CJT-Robotics/hardware-docs/README.md

# hardware-docs
Short and consise wiki for our hardware

>[!TIP]
>Click on the **Wiki** tab shown here, to access the hardware documentation wiki.
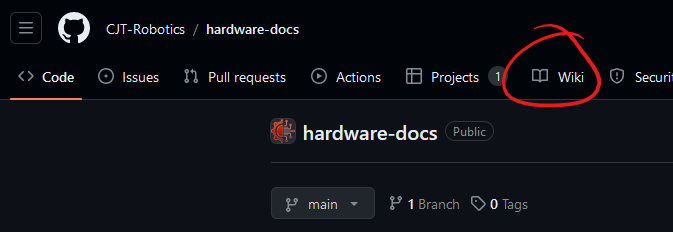
[picture p1: assets/images/klick-here.png]
instruction (https://github.com/CJT-Robotics/hardware-docs/wiki)
>
>
>Or click [HERE](https://github.com/CJT-Robotics/hardware-docs/wiki) to access the Wiki.
