CJT-Robotics/hardware-docs/assets/images/XT90-to-XT60-PCB/XT90-to-XT60-PCB-(3).png

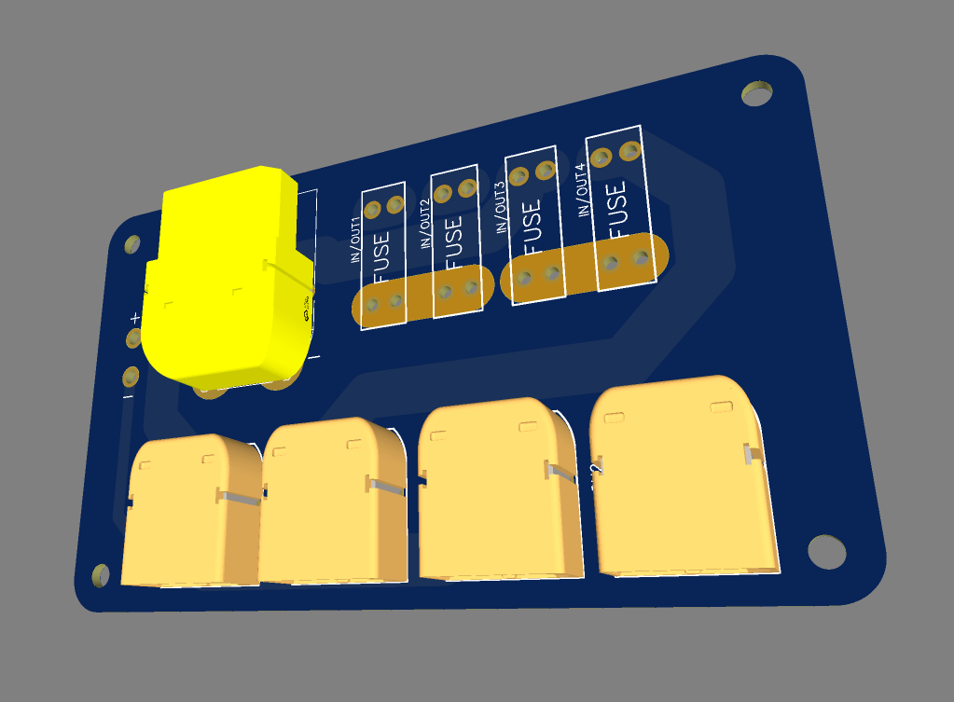
assets/images/XT90-to-XT60-PCB/XT90-to-XT60-PCB-(3).png
