CJT-Robotics/hardware-docs/assets/gerber/PCB_xt90 to xt60_2024-04-02.dxf

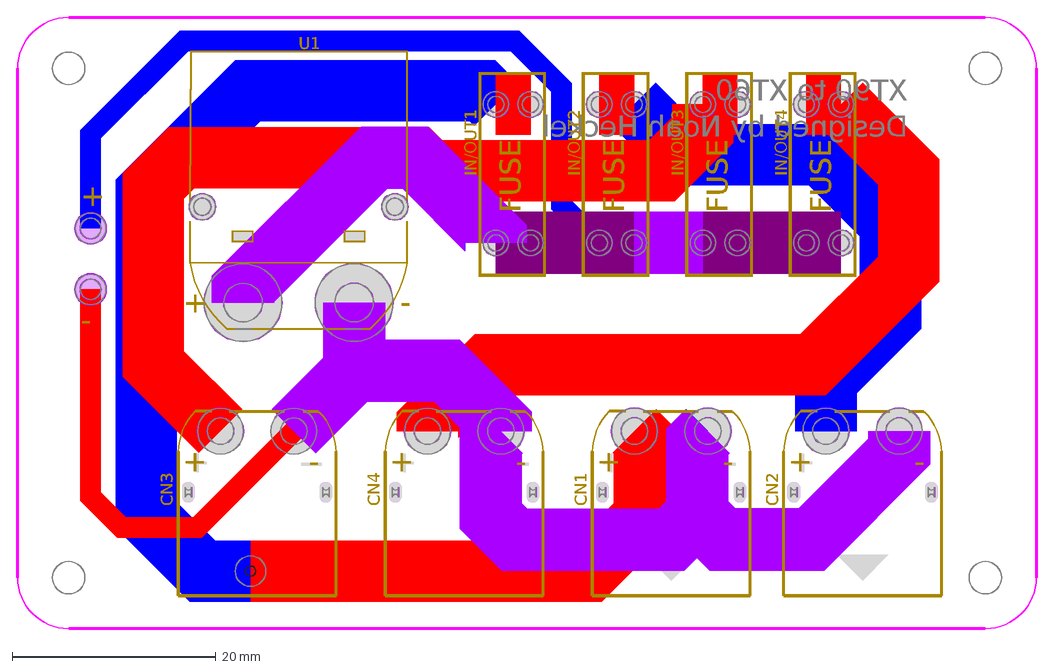
[picture p10: CAD file, 2024-04-02]
assets/gerber/PCB_xt90 to xt60_2024-04-02.dxf
+
-
XT90 to XT60
Designed by Noah Heckel
IN/OUT1
FUSE
IN/OUT2
IN/OUT3
IN/OUT4
CN1
CN2
CN3
CN4
U1
