CJT-Robotics/hardware-docs/assets/PDFs/Weel-Hub-drawings-v10-(FINAL).pdf

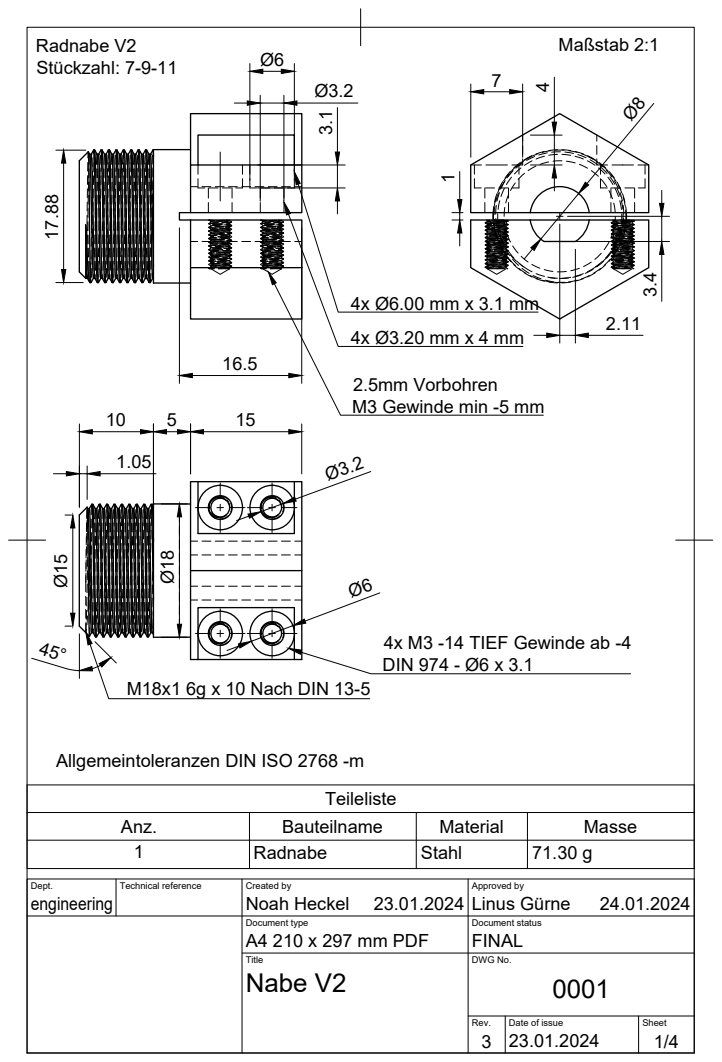
[picture p11: page 1]
DIN 974 - Ø6 x 3.1 3.1; M18x1 6g x 10 Nach DIN 13-5; Radnabe V2; Maßstab 2:1; Stückzahl: 7-9-11 17.88

2.5mm Vorbohren
M3 Gewinde min -5 mm

4x M3 -14 TIEF Gewinde ab -4

Allgemeintoleranzen DIN ISO 2768 -m

Anz. | Bauteilname | Material | Masse
1 | Radnabe | Stahl | 71.30 g

Dept. engineering | Technical reference | Created by Noah Heckel 23.01.2024 | Approved by Linus Gürne 24.01.2024

Document type A4 210 x 297 mm PDF | Document status FINAL

Title Nabe V2 | DWG No. 0001

Rev. 3 | Date of issue 23.01.2024 | Sheet

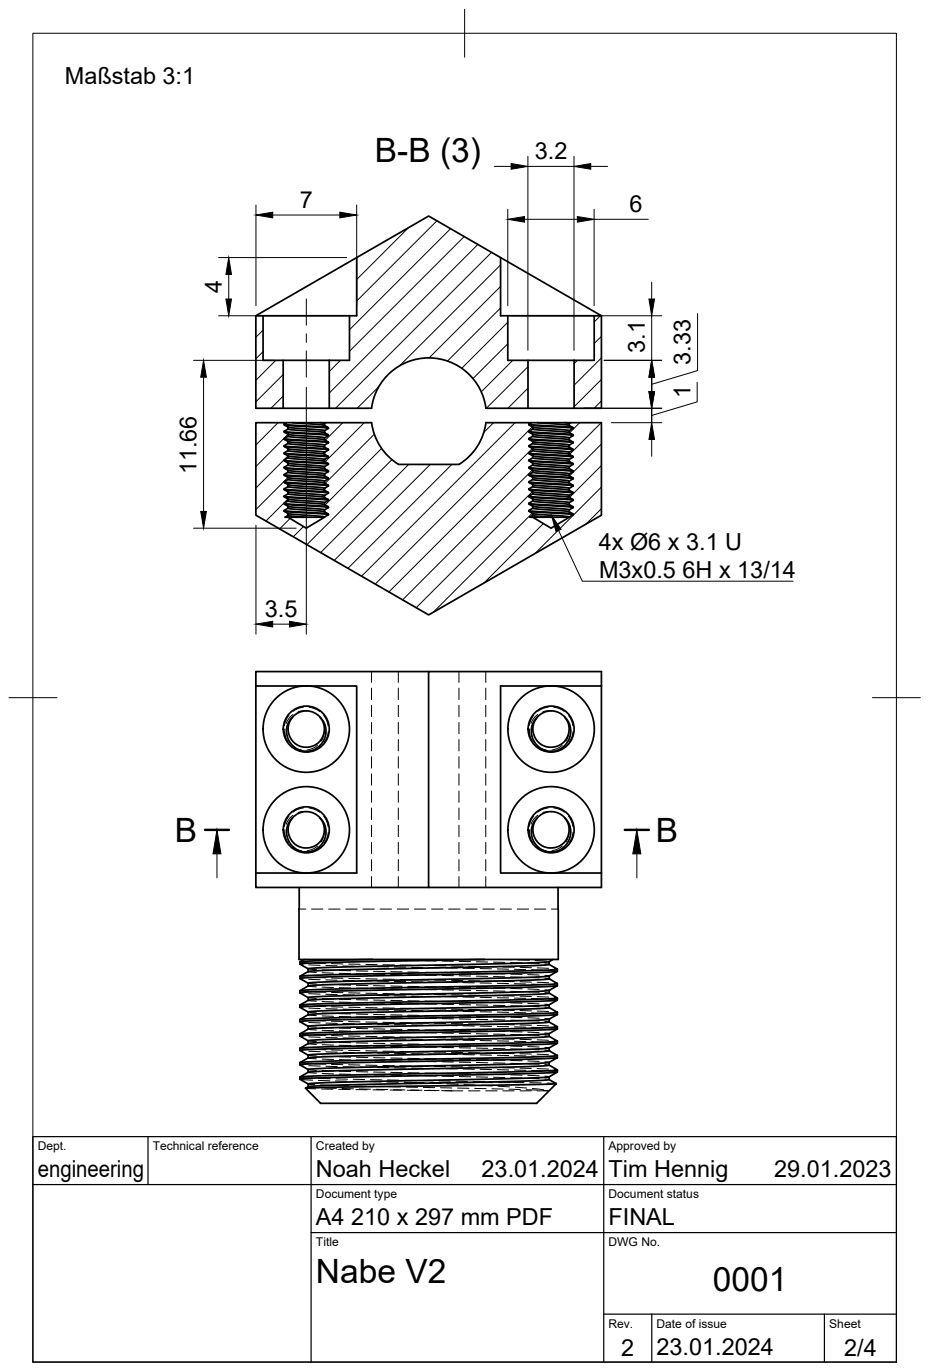
[picture p12: page 2]
Maßstab 3:1

Dept. engineering | Technical reference | Created by Noah Heckel 23.01.2024 | Approved by Tim Hennig 29.01.2023

Document type A4 210 x 297 mm PDF | Document status FINAL

Title Nabe V2 | DWG No. 0001

Dept. engineering | Technical reference | Created by Noah Heckel 23.01.2024 | Approved by Tim Hennig 29.01.2023
| | Document type A4 210 x 297 mm PDF | Document status FINAL
| | Title Nabe V2 | DWG No. 0001
Rev. | Date of issue | Sheet

Rohling

Material | Typ | Länge | Toleranz
11SMn30/37+C | Sechskant SW 24 | 27mm | h11 oder besser

Toleranzen nach DIN ISO 2768

| 0,5-3 | 3-6 | 6-30 | 30-120 | 120-400 | 400-1000 | 1000-200 0 | 2000-400 0
fein (f) | ±0,05 ±0,10 | ±0,05 ±0,10 | ±0,20 ±0,1 | ±0,15 ±0,30 | ±0,5 ±0,2 | ±0,3 ±0,8 | ±0,5 ±1,0 | ±2 - mittel (m)
grob (c) | ±0,20 | ±0,30 | ±0,50 | ±0,80 | ±1,2 | ±2,0 | ±3,0 | ±4
sehr grob (v) | - | ±0,50 | ±1,0 | ±1,50 | ±2,5 | ±4,0 | ±6,0 | -

Anbauteile
4x Schraube | M3x0,5 x 10mm | DIN 912 | Edelstahl/Verzinkt
1x Mutter | M18x1 | DIN 439 / ISO 8675 | Edelstahlt/Verzinkt
Motor | Ø8mm Welle | - | -

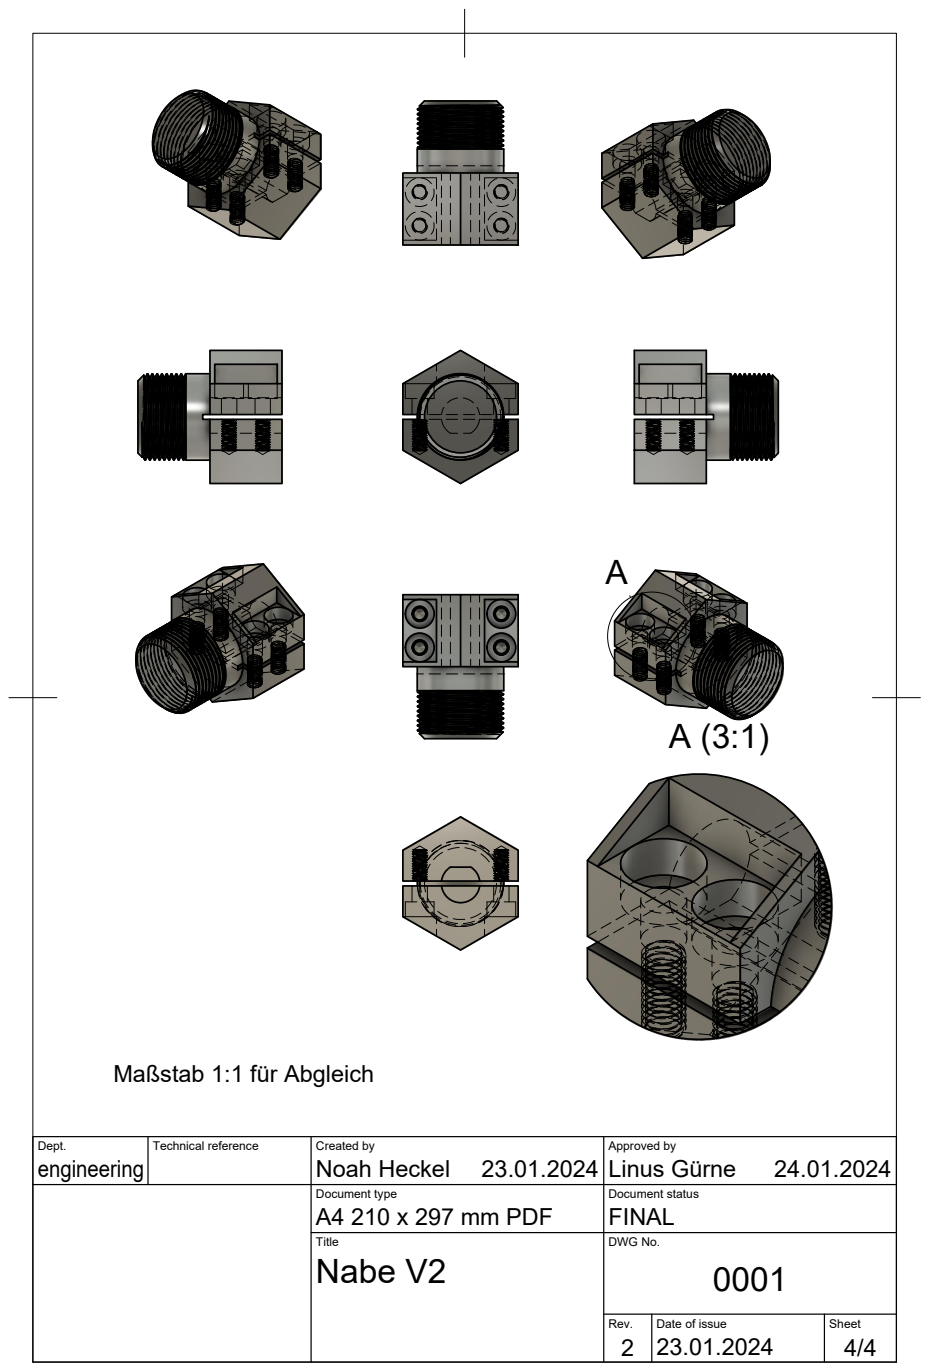
[picture p13: page 4]
Dept.; Technical reference; Created by; Approved by; Document type; Document status; Title; DWG No.; A4 210 x 297 mm PDF; FINAL; Nabe V2; engineering; Noah Heckel; Linus Gürne

Maßstab 1:1 für Abgleich
