CJT-Robotics/hardware-docs/(commit log)

2024-04-02 Revert "Rename YDLIDAR.X4.Lidar.User.Manual.-.YDLIDAR.X4.Lidar.User.Manual.V1.3.240124-1.pdf to YDLIDAR-Manual.pdf"
    This reverts commit deddf8be138edc186360d73c694b2a172dec2b8d.
2024-04-02 Added Files
    PDFs and Gerber Files
    [Drill_NPTH_Through.DRL, Drill_PTH_Through.DRL, Drill_PTH_Through_Via.DRL, Gerber_BoardOutlineLayer.GKO, Gerber_BottomLayer.GBL, Gerber_BottomSolderMaskLayer.GBS, Gerber_TopLayer.GTL, Gerber_TopSilkscreenLayer.GTO]
2024-04-02 gerber files sorted
    [Drill_NPTH_Through.DRL, Drill_PTH_Through.DRL, Drill_PTH_Through_Via.DRL, Gerber_BoardOutlineLayer.GKO, Gerber_BottomLayer.GBL, Gerber_BottomSolderMaskLayer.GBS, Gerber_TopLayer.GTL, Gerber_TopSilkscreenLayer.GTO]
2024-04-02 added pictures
    [PCB_xt90 to xt60_2024-04-02.dxf]
2024-04-02 Rename Create XT90-to-XT60-PCB-(1).png to XT90-to-XT60-PCB-(1).png
